JessedotTaylor/StepperAndControl/PCB Files/StepperDriver/StepperDriver.kicad_pcb

## KiCad design PCB Files/StepperDriver/StepperDriver.kicad_pcb (2020-06-17)

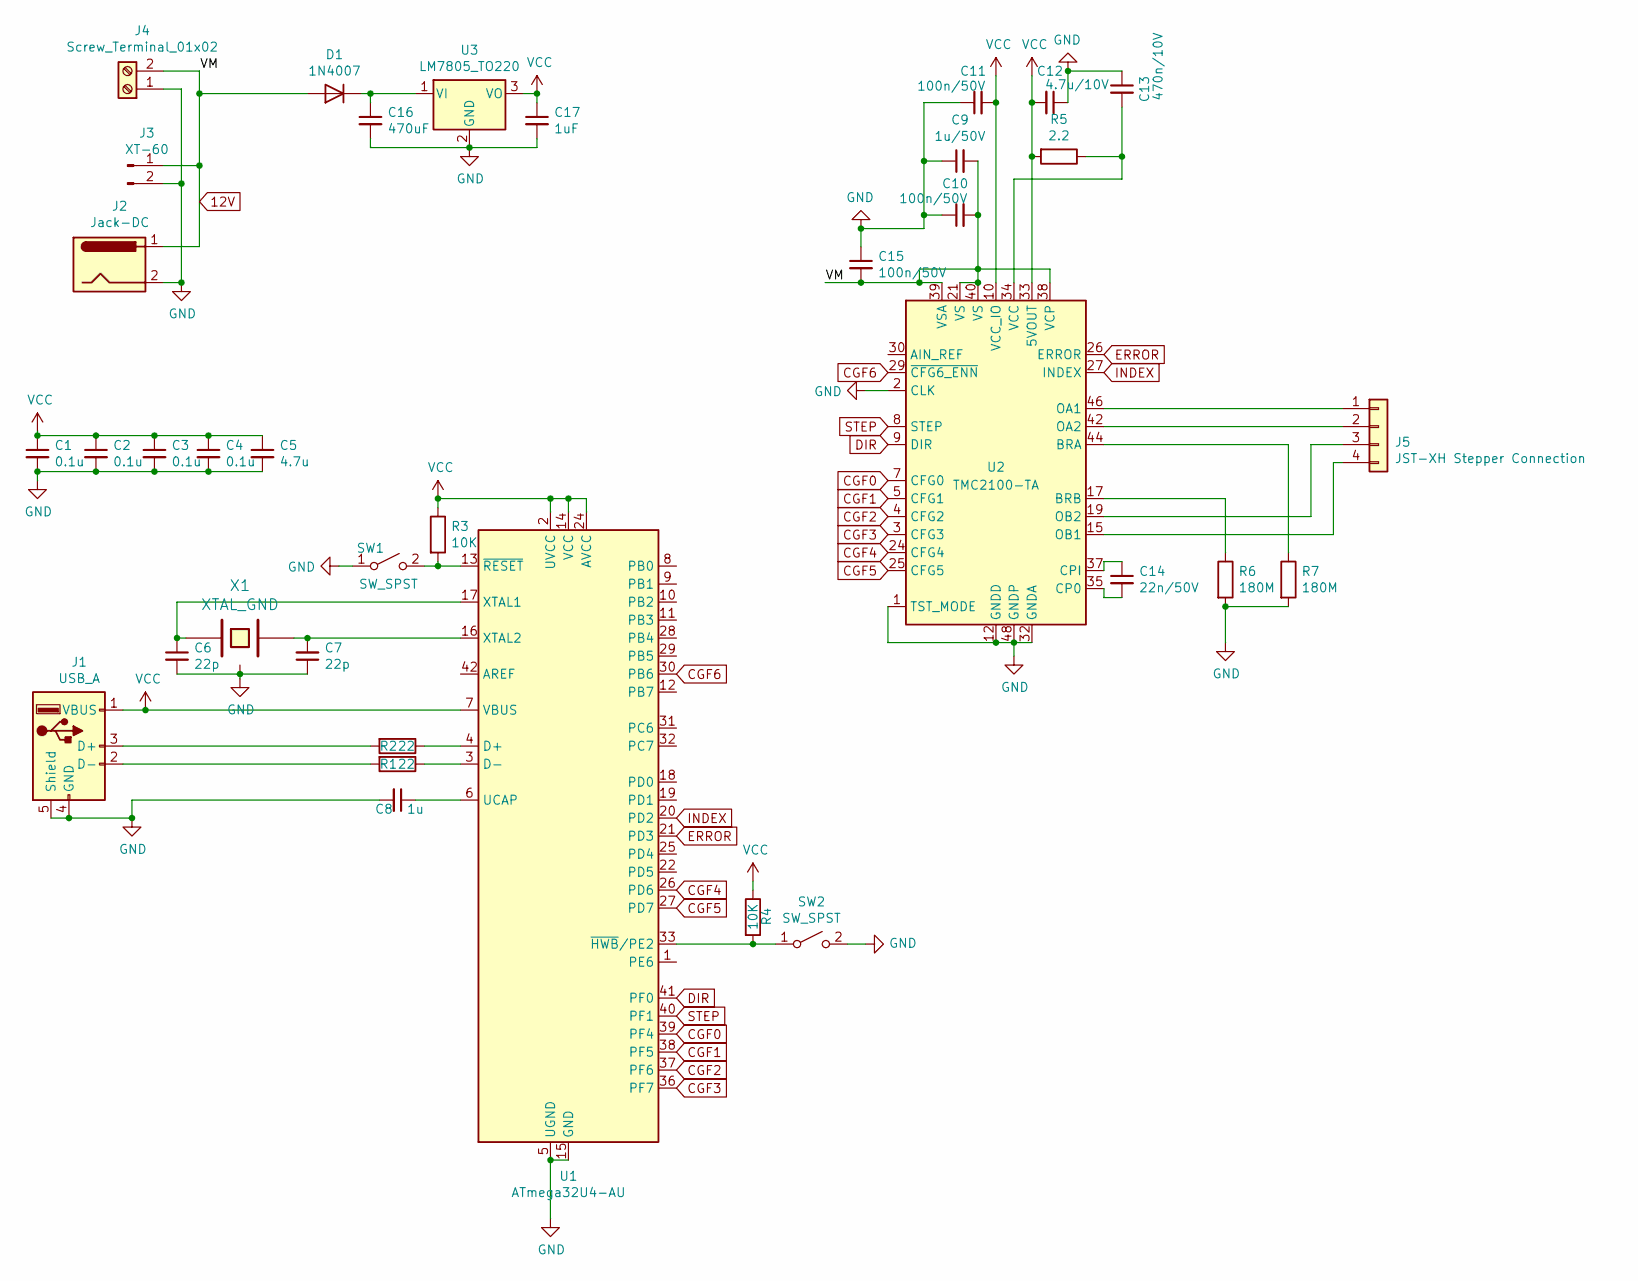
[picture p15: schematic StepperDriver.sch]

Parts:
C1, C2, C3, C4: 0.1u; C_0805_2012Metric_Pad1.15x1.40mm_HandSolder
C5: 4.7u; C_0805_2012Metric_Pad1.15x1.40mm_HandSolder
C6, C7: 22p; C_0805_2012Metric_Pad1.15x1.40mm_HandSolder
C8: 1u; C_0805_2012Metric_Pad1.15x1.40mm_HandSolder
C9: 1u/50V; C_0805_2012Metric_Pad1.15x1.40mm_HandSolder
C10, C11, C15: 100n/50V; C_2010_5025Metric_Pad1.52x2.65mm_HandSolder
C12: 4.7u/10V; C_0805_2012Metric_Pad1.15x1.40mm_HandSolder
C13: 470n/10V; C_0805_2012Metric_Pad1.15x1.40mm_HandSolder
C14: 22n/50V; C_2010_5025Metric_Pad1.52x2.65mm_HandSolder
C16: 470uF; CP_Radial_D4.0mm_P1.50mm
C17: 1uF; CP_Radial_D4.0mm_P1.50mm
D1: 1N4007; D_DO-41_SOD81_P10.16mm_Horizontal
J1: USB_A; USB_A_Molex_67643_Horizontal
J2: Jack-DC; BarrelJack_Horizontal
J3: XT-60; TestPoint_2Pads_Pitch5.08mm_Drill1.3mm
J4: Screw_Terminal_01x02; TerminalBlock_Altech_AK300-2_P5.00mm
J5: JST-XH Stepper Connection; JST_XH_B4B-XH-A_1x04_P2.50mm_Vertical
R1, R2: 22; R_0805_2012Metric_Pad1.15x1.40mm_HandSolder
R3, R4: 10K; R_0805_2012Metric_Pad1.15x1.40mm_HandSolder
R5: 2.2; R_0805_2012Metric_Pad1.15x1.40mm_HandSolder
R6, R7: 180M; R_0805_2012Metric_Pad1.15x1.40mm_HandSolder
SW1, SW2: SW_SPST; SW_SPST_TL3342
U1: ATmega32U4-AU; TQFP-44_10x10mm_P0.8mm
U2: TMC2100-TA; TQFP-48-1EP_7x7mm_P0.5mm_EP5x5mm_ThermalVias
U3: LM7805_TO220; TO-220-3_Vertical
X1: XTAL_GND; Crystal_SMD_SeikoEpson_FA238-4Pin_3.2x2.5mm_HandSoldering

Connections:
12V: C9.2, C10.2, C15.2, D1.2 (A), J2.1, J3.1, J4.2, U2.21 (VS), U2.38 (VCP), U2.39 (VSA), U2.40 (VS)
CGF0: U1.39 (PF4), U2.7 (CFG0)
CGF1: U1.38 (PF5), U2.5 (CFG1)
CGF2: U1.37 (PF6), U2.4 (CFG2)
CGF3: U1.36 (PF7), U2.3 (CFG3)
CGF4: U1.26 (PD6), U2.24 (CFG4)
CGF5: U1.27 (PD7), U2.25 (CFG5)
CGF6: U1.30 (PB6), U2.29 (~CFG6_ENN)
DIR: U1.41 (PF0), U2.9 (DIR)
ERROR: U1.21 (PD3), U2.26 (ERROR)
GND: C1.2, C2.2, C3.2, C4.2, C5.2, C6.2, C7.1, C8.2, C9.1, C10.1, C11.1, C12.1, C13.1, C15.1, C16.2, C17.2, J1.4 (GND), J1.5 (Shield), J2.2, J3.2, J4.1, R6.2, R7.2, SW1.1 (A), SW2.2 (B), U1.5 (UGND), U1.15 (GND), U1.23 (GND), U1.35 (GND), U1.43 (GND), U2.1 (TST_MODE), U2.2 (CLK), U2.6 (GNDD), U2.12 (GNDD), U2.13 (GNDP), U2.31 (GNDD), U2.32 (GNDA), U2.36 (GNDD), U2.48 (GNDP), U2.49 (GNDD), U3.2 (GND), X1.3
INDEX: U1.20 (PD2), U2.27 (INDEX)
unnamed: C6.1, U1.17 (XTAL1), X1.1
unnamed: C7.2, U1.16 (XTAL2), X1.2
unnamed: C8.1, U1.6 (UCAP)
unnamed: C13.2, R5.1, U2.34 (VCC)
unnamed: C14.1, U2.37 (CPI)
unnamed: C14.2, U2.35 (CP0)
unnamed: C16.1, D1.1 (K), U3.1 (VI)
unnamed: J1.2 (D-), R1.2
unnamed: J1.3 (D+), R2.2
unnamed: J5.1, U2.46 (OA1)
unnamed: J5.2, U2.42 (OA2)
unnamed: J5.3, U2.19 (OB2)
unnamed: J5.4, U2.15 (OB1)
unnamed: R1.1, U1.3 (D-)
unnamed: R2.1, U1.4 (D+)
unnamed: R3.2, SW1.2 (B), U1.13 (~RESET)
unnamed: R4.2, SW2.1 (A), U1.33 (~HWB~/PE2)
unnamed: R6.1, U2.17 (BRB)
unnamed: R7.1, U2.44 (BRA)
STEP: U1.40 (PF1), U2.8 (STEP)
VCC: C1.1, C2.1, C3.1, C4.1, C5.1, C11.2, C12.2, C17.1, J1.1 (VBUS), R3.1, R4.1, R5.2, U1.2 (UVCC), U1.7 (VBUS), U1.14 (VCC), U1.24 (AVCC), U1.34 (VCC), U1.44 (AVCC), U2.10 (VCC_IO), U2.33 (5VOUT), U3.3 (VO)

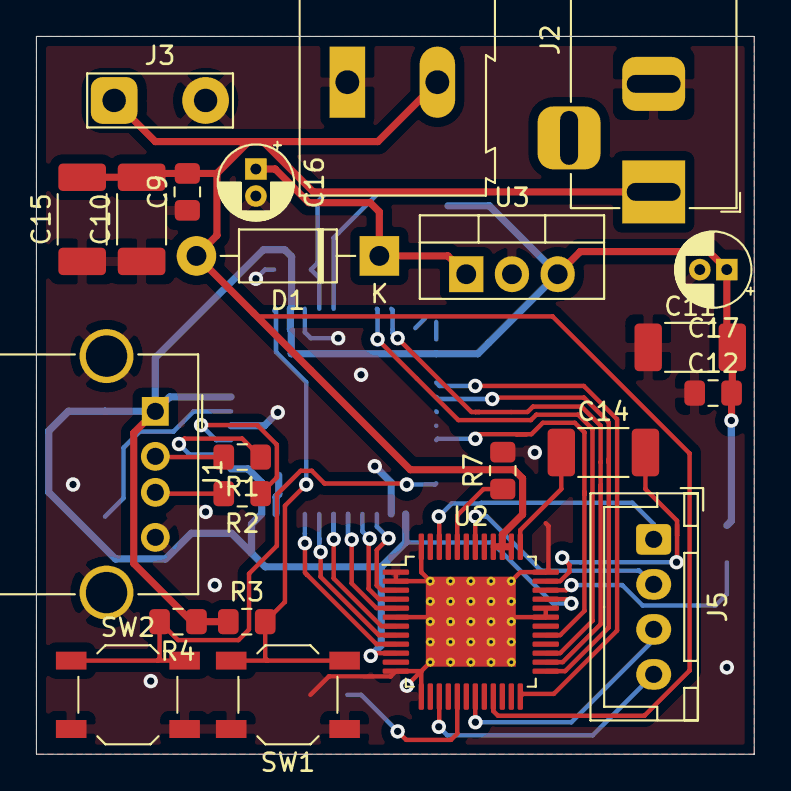
[picture p16: board StepperDriver.kicad_pcb from above]

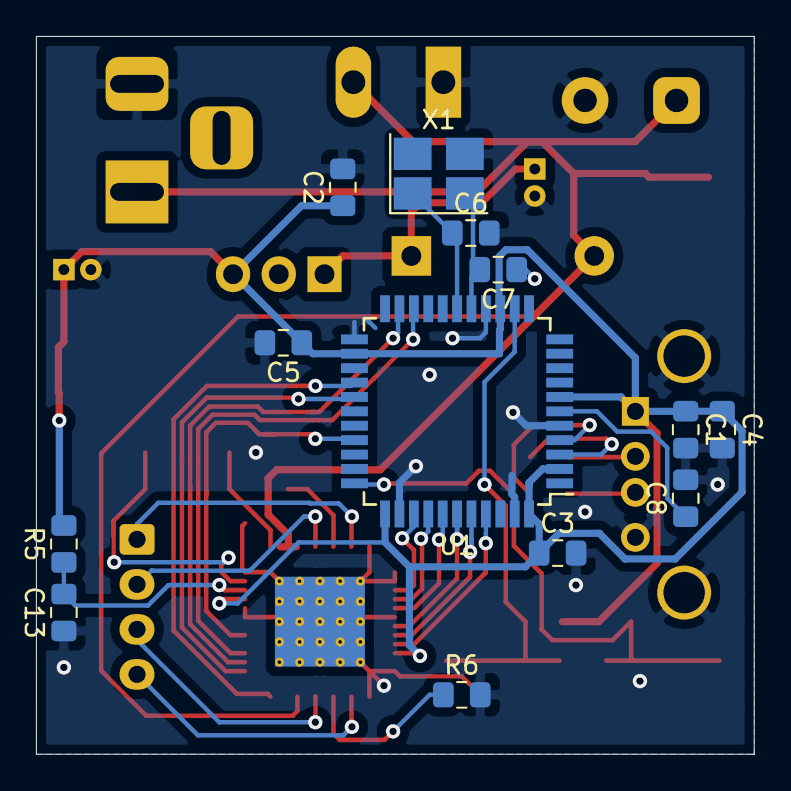
[picture p17: board StepperDriver.kicad_pcb from below]

Board: 2 copper layers, 39.9 x 39.9 mm, 36 parts (13 on the bottom side), 33 nets.
